freetronics/USBASP/USBASP.brd

## EAGLE design USBASP.brd (2013-04-16)

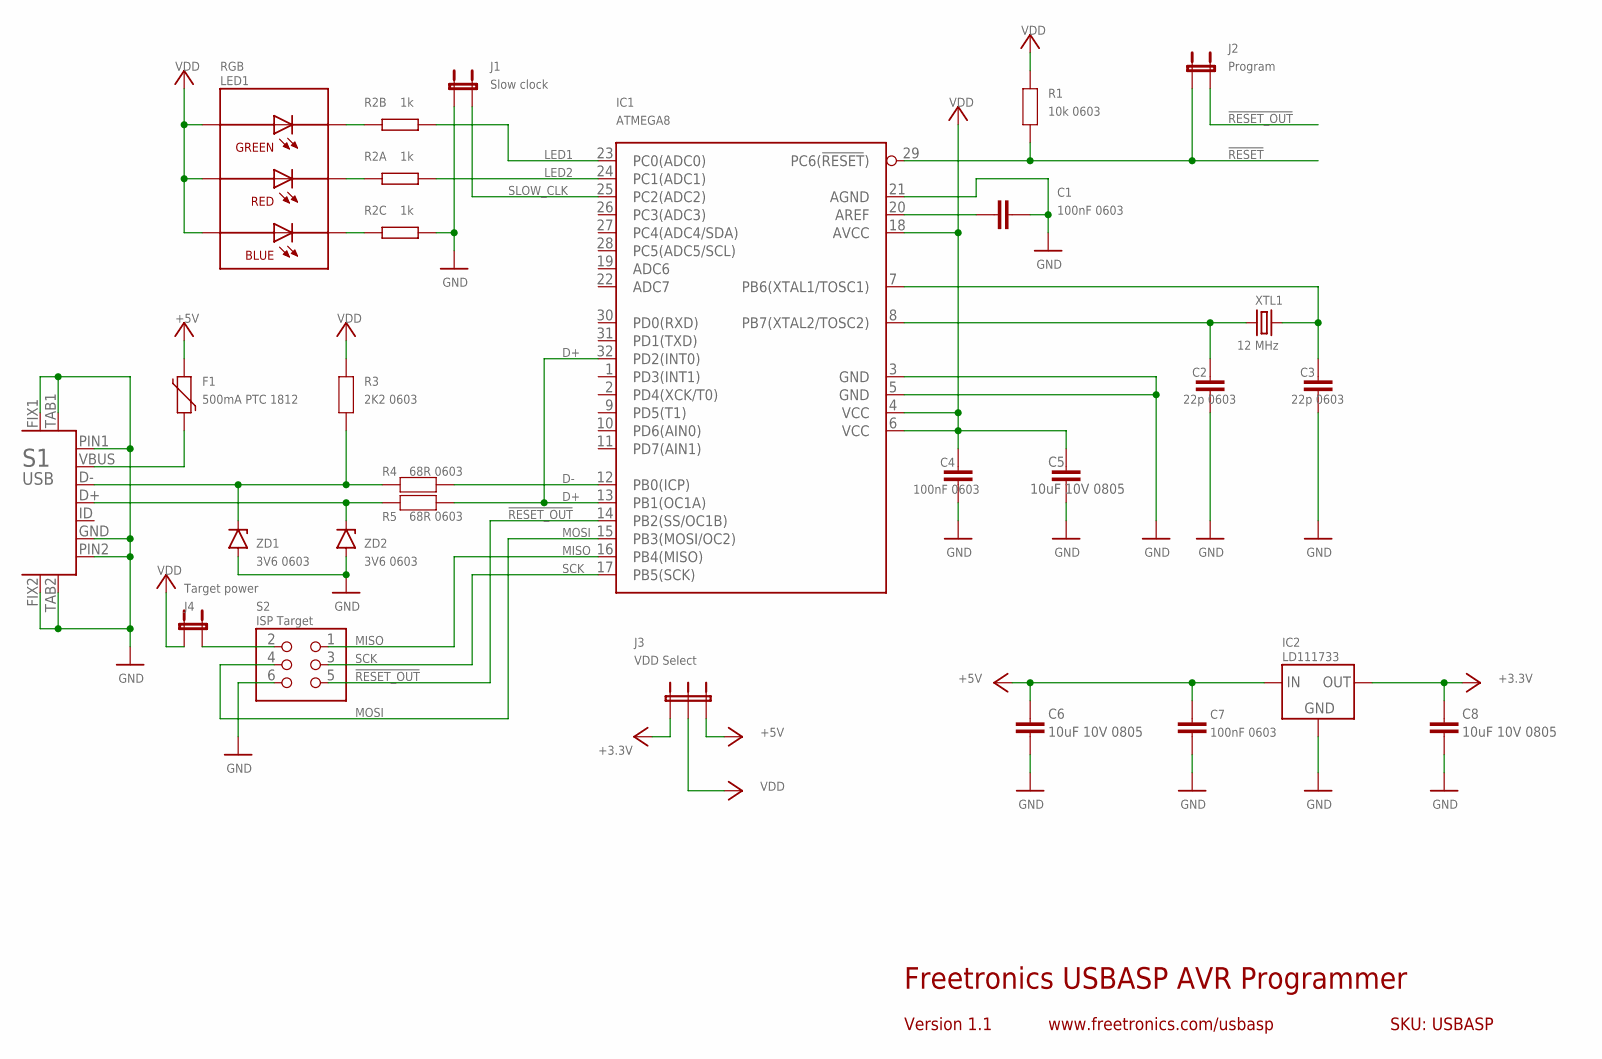
[picture p1: schematic USBASP.sch]

Parts:
C1, C4, C7: 100nF 0603; 0603
C2, C3: 22p 0603; 0603
C5, C6, C8: 10uF 10V 0805; C0805
F1: 500mA PTC 1812; 1812
IC1: ATMEGA8; TQFP32-08
IC2: LD111733; SOT-223
J1: Slow clock; HEADER_1X02
J2: Program; HEADER_1X02
J3: VDD Select; JUMPER_SPDT
J4: Target power; HEADER_1X02
LED1: RGB; 19-337
R1: 10k 0603; 0603
R2: 1k; CAY16
R3: 2K2 0603; 0603
R4, R5: 68R 0603; 0603
S1: USB; USB-MICROB-MB05PMXX
S2: ISP Target; HEADER_2X3
XTL1: 12 MHz; HC49US
ZD1, ZD2: 3V6 0603; MINIMELF

Connections:
!RESET: IC1.29 (PC6(!RESET!)), J2.1, R1.1
!RESET_OUT: IC1.14 (PB2(SS/OC1B)), J2.2, S2.5
+3V3: C8.1, IC2.2 (OUT), IC2.4 (OUT), J3.1
+5V: C6.1, C7.1, F1.2, IC2.3 (IN), J3.3
D+: IC1.13 (PB1(OC1A)), IC1.32 (PD2(INT0)), R5.1
D-: IC1.12 (PB0(ICP)), R4.1
GND: C1.2, C2.1, C3.1, C4.2, C5.2, C6.2, C7.2, C8.2, IC1.3 (GND), IC1.5 (GND), IC1.21 (AGND), IC2.1 (GND), J1.1, R2.3 (1), S1.FIX1, S1.FIX2, S1.GND, S1.PIN1, S1.PIN2, S1.TAB1, S1.TAB2, S2.6, ZD1.A, ZD2.A
LED1: IC1.23 (PC0(ADC0)), R2.2 (1)
LED2: IC1.24 (PC1(ADC1)), R2.1
MISO: IC1.16 (PB4(MISO)), S2.1
MOSI: IC1.15 (PB3(MOSI/OC2)), S2.4
unnamed: LED1.1 (C-B), R2.6 (2)
unnamed: LED1.2 (C-R), R2.8 (2)
unnamed: LED1.3 (C-G), R2.7 (2)
unnamed: J4.2, S2.2
unnamed: C3.2, IC1.7 (PB6(XTAL1/TOSC1)), XTL1.2
unnamed: C2.2, IC1.8 (PB7(XTAL2/TOSC2)), XTL1.1
unnamed: F1.1, S1.VBUS
unnamed: C1.1, IC1.20 (AREF)
unnamed: R5.2, S1.D+, ZD2.K
unnamed: R3.1, R4.2, S1.D-, ZD1.K
SCK: IC1.17 (PB5(SCK)), S2.3
SLOW_CLK: IC1.25 (PC2(ADC2)), J1.2
VDD: C4.1, C5.1, IC1.4 (VCC), IC1.6 (VCC), IC1.18 (AVCC), J3.2, J4.1, LED1.4 (A-B), LED1.5 (A-R), LED1.6 (A-G), R1.2, R3.2

Notes on the sheet:
Freetronics USBASP AVR Programmer
Version 1.1
www.freetronics.com/usbasp
SKU: USBASP

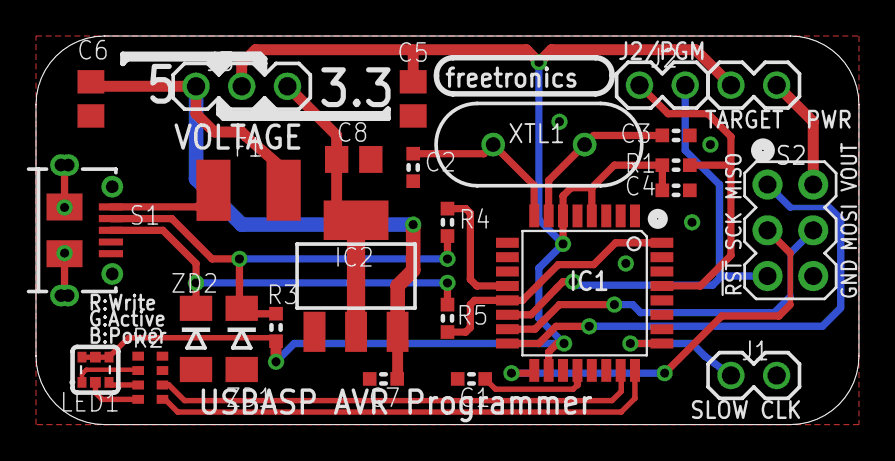
[picture p2: board USBASP.brd from above]

Board: 2 copper layers, 45.7 x 21.6 mm, 26 parts (0 on the bottom side), 24 nets.
