freetronics/USBASP/(commit log)

2012-05-16 changed zeners to miniMELF, moved jumpers to increase clearance around ISP header, added 10uF cap on 5V rail.
    [AVRProg.brd, AVRProg.sch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]
2012-09-26 Schematic and layout improvements
    [AVRProg.brd, AVRProg.sch]
2013-04-07 Renamed project to USBASP
    [AVRISP.brd, AVRISP.sch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]
2013-04-07 Renamed project
    [USBASP.brd, USBASP.sch]
2013-04-07 Updates for v1.0 release
    [USBASP.brd, USBASP.sch]
2013-04-16 Added jumper to enable / disable target power; improved labels
    [USBASP.brd, USBASP.sch]
