freetronics/USBASP/(notices)

Notices in the files:
USBASP.brd:
(c) 2013 Freetronics Pty Ltd
Licensed under the TAPR
Open Hardware License
